Huanfiy/ai-link/docs/refs/sche/Schematic.pdf

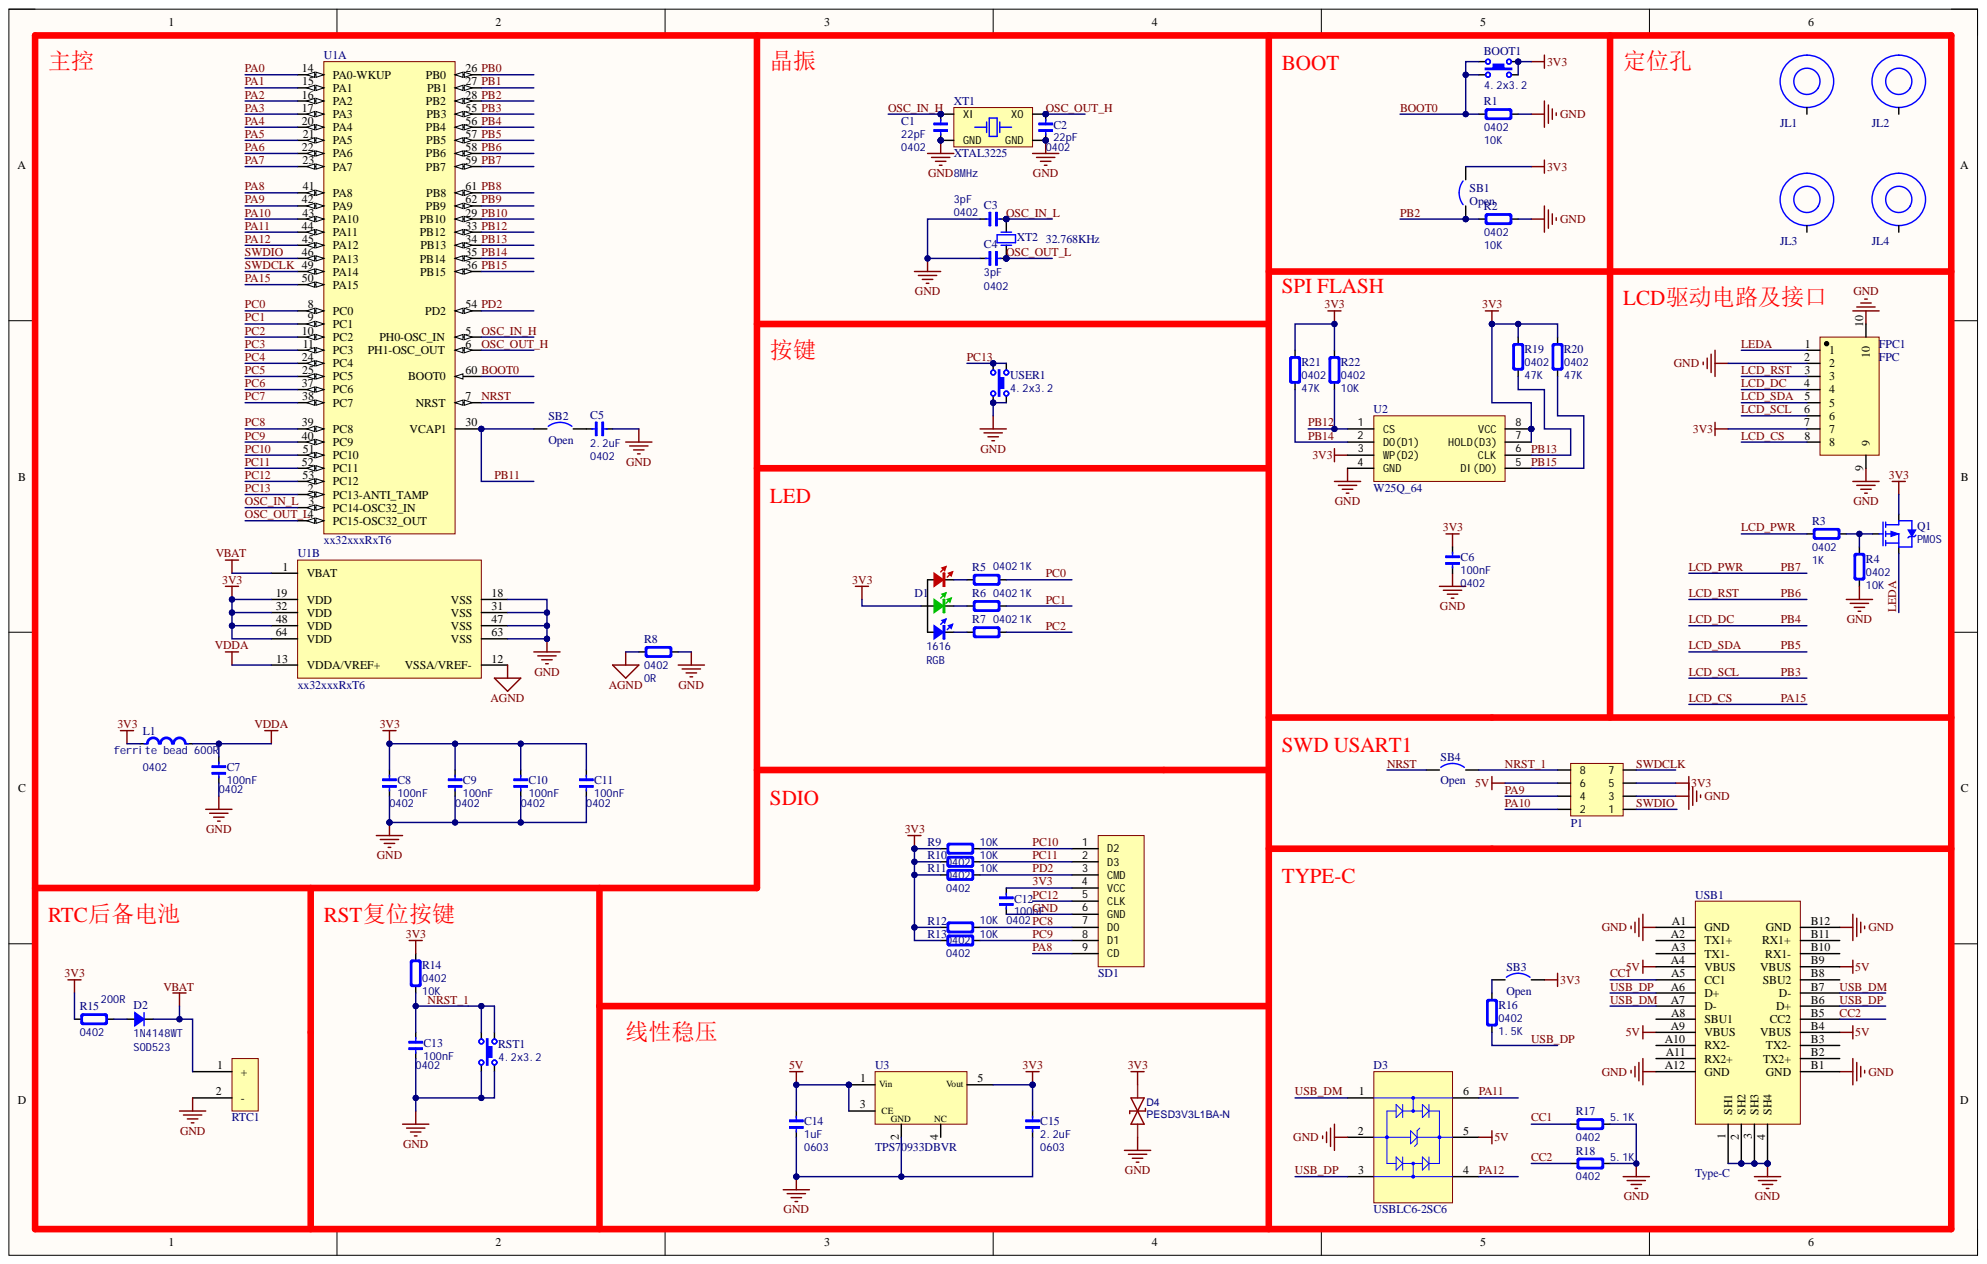
[picture p1: page 1]

R11 | 0402 10K PD2 | CMD 3
R12 | 0402 3V3 0402 10K | VCC 4
