Huanfiy/ai-link/(commit log)

2026-07-16 init: 整理项目框架
2026-07-16 📝 docs(rttenv): 修正虚拟环境与工作流说明
2026-07-17 📝 docs(rttenv): 收紧技能触发条件
2026-07-17 🎨 refactor(build): 收敛 Linux/gcc 构建契约与产物输出
2026-07-17 🔧 chore(kconfig): 调整 SoC 选择并接入 board Kconfig
2026-07-17 📝 docs: 移除过时的构建可视化笔记
2026-07-17 🔧 chore: 收敛 .gitignore 构建产物忽略范围
2026-07-17 ✨ feat(build): 新增 run.sh 构建与 OpenOCD 烧录脚本
2026-07-17 ✨ feat(build): 链接后输出固件内存占用报告
2026-07-17 🔧 chore: 新增 clangd 语义分析与 clang-format/clang-tidy 风格配置
2026-07-17 🔧 chore: 收录 VS Code 参考配置并收窄 .vscode 忽略范围
2026-07-17 🔧 chore: .clangd 改为本地不跟踪并收录参考副本
2026-07-17 🐞 fix(flash): 默认显示烧录输出
2026-07-17 📝 docs: 新增 AGENTS.md 与代码/文档治理规则文档
2026-07-20 🐞 fix: 按核心板实际型号修正芯片标识为 STM32F446RET6
    [CubeMX_Config.ioc]
2026-07-20 📝 docs: 修正文档中失实的芯片型号与烧录探针描述
2026-07-20 chore: 配置 16M 晶振的分频系数
2026-07-20 🔧 chore: 移除 drv_spi 遗留调试打印
2026-07-20 ✨ feat(board): 外设底座就绪：uart2 控制台、uart1/6 DMA、SPI2、CherryUSB OTG_FS 与 PLLSAI 48MHz
2026-07-20 🐞 fix(app): 主程序 LED 改为板载 RGB PC0-2 跑马灯
    [main.c]
2026-07-20 ✨ feat(boot): 二级启动分区：boot@0x08000000 + app@0x08010000、fw_info CRC 校验与 ROM DFU 跳板
2026-07-20 ✨ feat(fs): SPI Flash elmFAT 挂载根目录，首次挂载失败自动格式化
2026-07-20 ✨ feat(usb): USB 复合设备：双 CDC ACM + CMSIS-DAP v2 + MSOSv2 WinUSB 描述符与数据泵
2026-07-20 ✨ feat(tools): 主机工具适配 1209:0010 复合设备与 F446 board_id
2026-07-20 📝 docs: 新增 usb-bridge 与 ota 设计文档，AGENTS.md 同步固件架构与实板晶振事实
2026-07-20 📝 docs: 回填 usb-bridge 与 ota 设计文档的上板验证结论
2026-07-20 🐞 fix(usb): 泵 TX 改单节点暂存合批，规避 serial v1 DMA 队列竞态导致的 2M+ 停摆
    [bridge_pump.c]
2026-07-20 📝 docs: 回填串口回环实测吞吐与 TX 竞态修复说明
2026-07-20 📝 docs: 新增 README：项目定位、构建烧录与主机侧使用
2026-07-20 📝 docs(perf): 新增 DAPLink、串口与升级性能基线
2026-07-28 ✨ feat(usb): CDC 串口按主机读取在场感知门控转发，未打开端口不缓存不回放
2026-07-28 📝 docs(design): 新增 CDC 转发门控设计文档，记录两条设计边界与闭环验收结论
2026-07-29 📝 docs(readme): 添加接口接线说明图
2026-09-06 ✨ feat(product): 适配 v0.4 产品板供电时序与通信指示
2026-09-06 📝 docs(agents): 修正 RT-Thread 版本为 5.2.2
2026-09-06 📝 docs(readme): 重构产品首页并完善 SVG 视觉展示
